mehmetfurkandogan/CNC-modernization/Literature search notes/MFD Literature Search.md

## Controller Options

🤔 Online or offline controller

- [Klipper3D](https://www.klipper3d.org/)

- [LinuxCNC](http://linuxcnc.org/)
  
  [Emco Compact 5 to LinuxCNC conversion. Introduction video.](https://www.youtube.com/watch?v=JxlS0DMkwLA)

- [OctoPrint](https://octoprint.org/)

- [DDCS v3.1](http://www.ddcnc.com/?m=home&c=View&a=index&aid=119&lang=en)
  
  [Build Your Own CNC Controller, Part 1 | DDCS V3.1 | 6040 Router](https://www.youtube.com/watch?v=X-DY6iL6NcI)
  
  - Variable Frequency Drive (VFD)

- [Mach3 CNC](https://www.machsupport.com/software/mach3/)
  
  [4 Eksen CNC Kontrol Kartı Mach3 USB Uyumlu](https://www.robolinkmarket.com/4-eksen-cnc-kontrol-karti-mach3-usb-uyumlu)
  
  [5 Eksen CNC Kontrol Kartı (MACH3 Uyumlu)](https://www.robolinkmarket.com/5-eksen-cnc-kontrol-karti-mach3-uyumlu)

- [Marlin](https://marlinfw.org/)

- [OpenBuilds](https://openbuilds.com/)

---

There is a 3 axis TB6560 driver board on the lathe right now.

[Board DataSheet](https://github.com/mehmetfurkandogan/CNC-modernization/blob/main/Documents/Stepper%20Motor%20Driver/3%20Axis%20TB6560%203.5A%20Stepper%20Motor%20Driver%20Board%20Man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)

[Toshiba TB6560AHQ chip DataSheet](https://www.mouser.com.tr/datasheet/2/408/Toshiba_TB6560AHQ_datasheet_en_20141001__3_-2325890.pdf)

[Tb6560 stepping motor driver board](https://www.direnc.net/tb6560-3-5a-step-motor-surucu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) [**DataSheet**](https://pdf.direnc.net/upload/tb6560-3-5a-step-motor-surucu-stepping-motor-driver-datasheet.pdf) 

 [winder](https://github.com/winder)/[**Universal-G-Code-Sender**](https://github.com/winder/Universal-G-Code-Sender) [UGS](https://winder.github.io/ugs_website/) to create g-codes

 [gnea](https://github.com/gnea)/**[grbl](https://github.com/gnea/grbl)**  can be used with arduino

 [picatostas](https://github.com/picatostas)/**[cnc_interface](https://github.com/picatostas/cnc_interface)** can be used for ROS integration

 [grblHAL](https://github.com/grblHAL)/**[RP2040](https://github.com/grblHAL/RP2040)** GRBL for RP2040
