mehmetfurkandogan/CNC-modernization/CNC Lathe Inspection Report/WhatsApp Image 2023-04-20 at 13.09.05.jpg

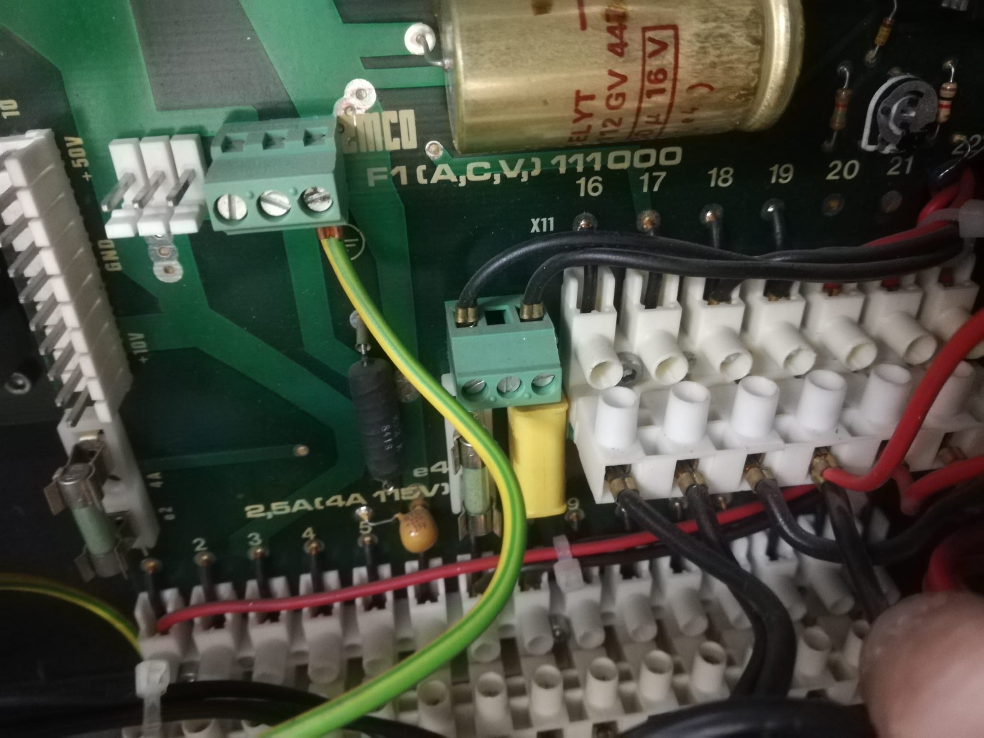
CNC Lathe Inspection Report/WhatsApp Image 2023-04-20 at 13.09.05.jpg
