mehmetfurkandogan/CNC-modernization/Documents/2023-05-25_001082.jpg

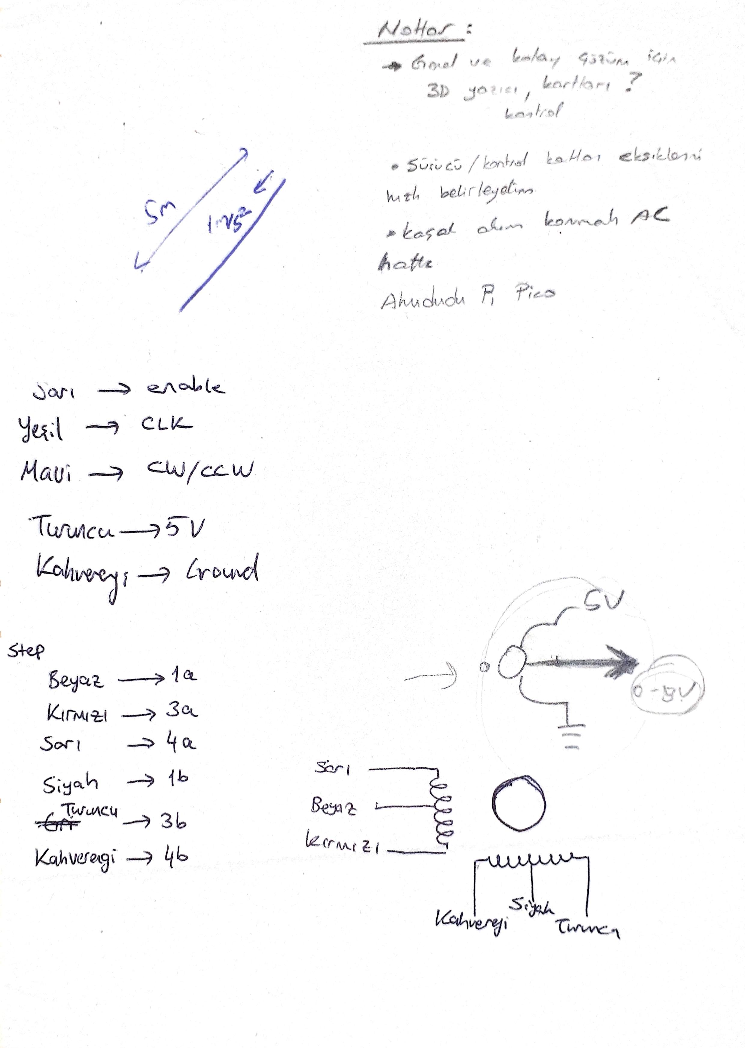
Documents/2023-05-25_001082.jpg
