mehmetfurkandogan/CNC-modernization/Documents/emco-compact-5-cnc-1.snapshot.6/Renderings/Emco Compact 5 CNC render.png

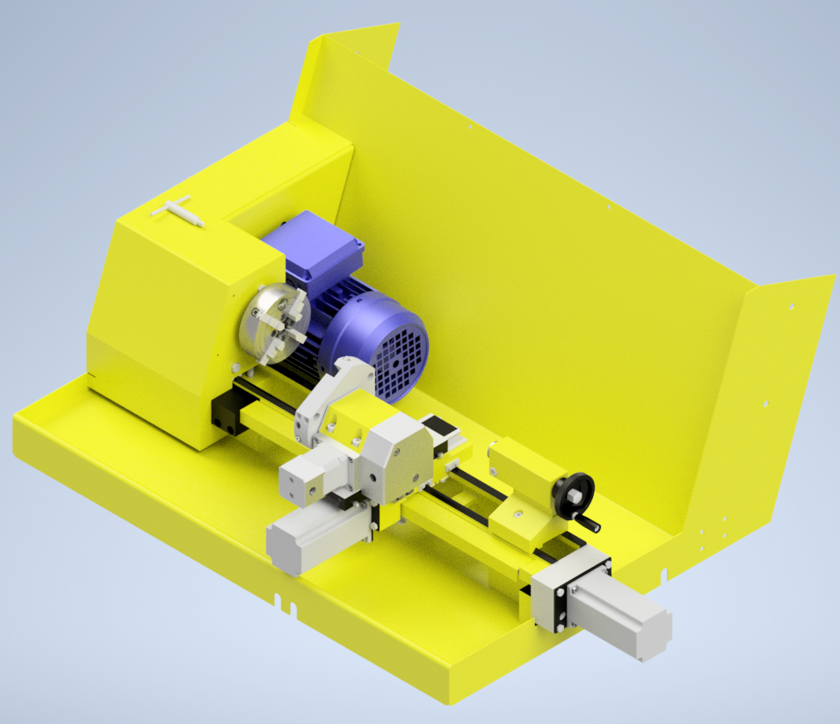
Documents/emco-compact-5-cnc-1.snapshot.6/Renderings/Emco Compact 5 CNC render.png
