mehmetfurkandogan/CNC-modernization/Documents/Encoder_schematic.webp

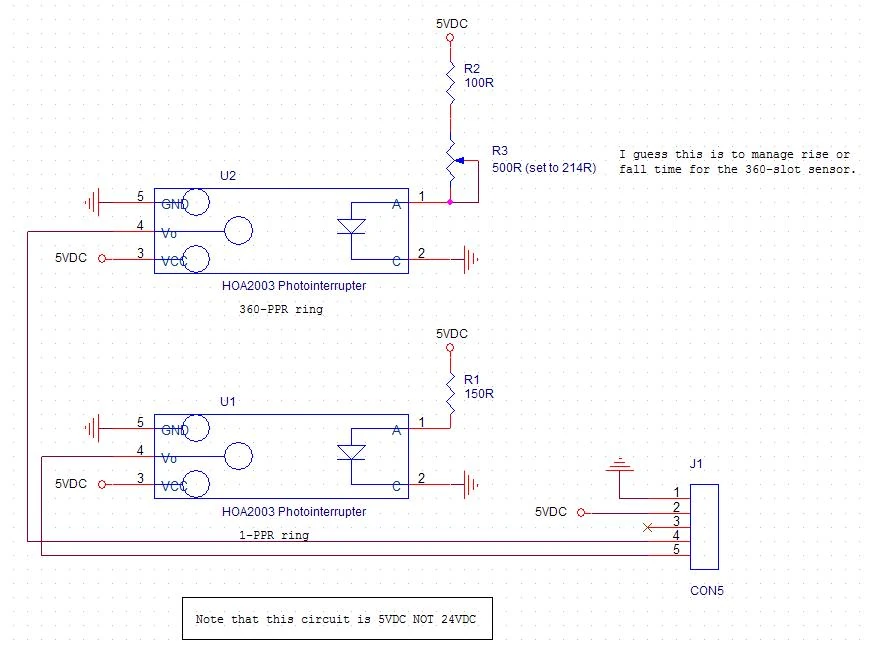
Documents/Encoder_schematic.webp
