mehmetfurkandogan/CNC-modernization/Documents/Spindle_specs.jpeg

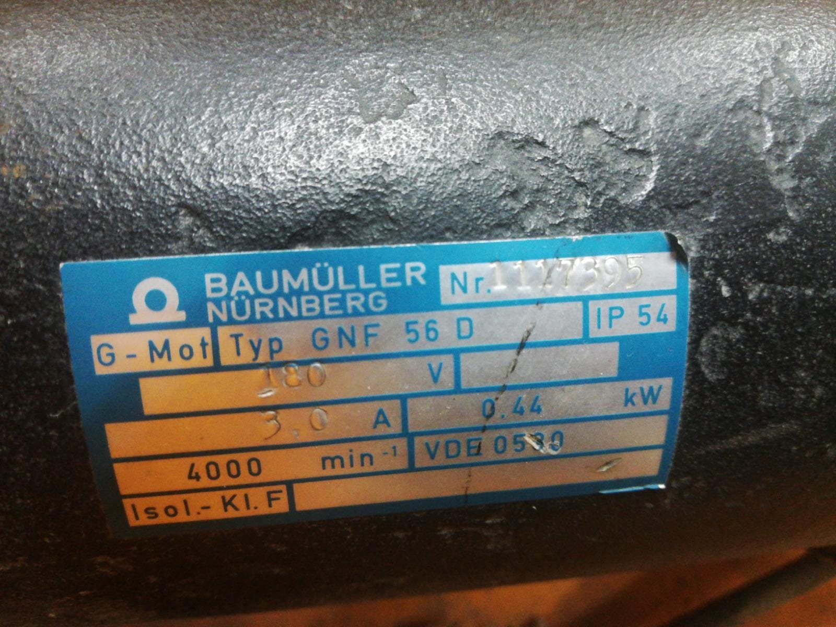
Documents/Spindle_specs.jpeg
