mehmetfurkandogan/CNC-modernization/Documents/Stepper Motor Driver/TB6560/Schematic.jpg

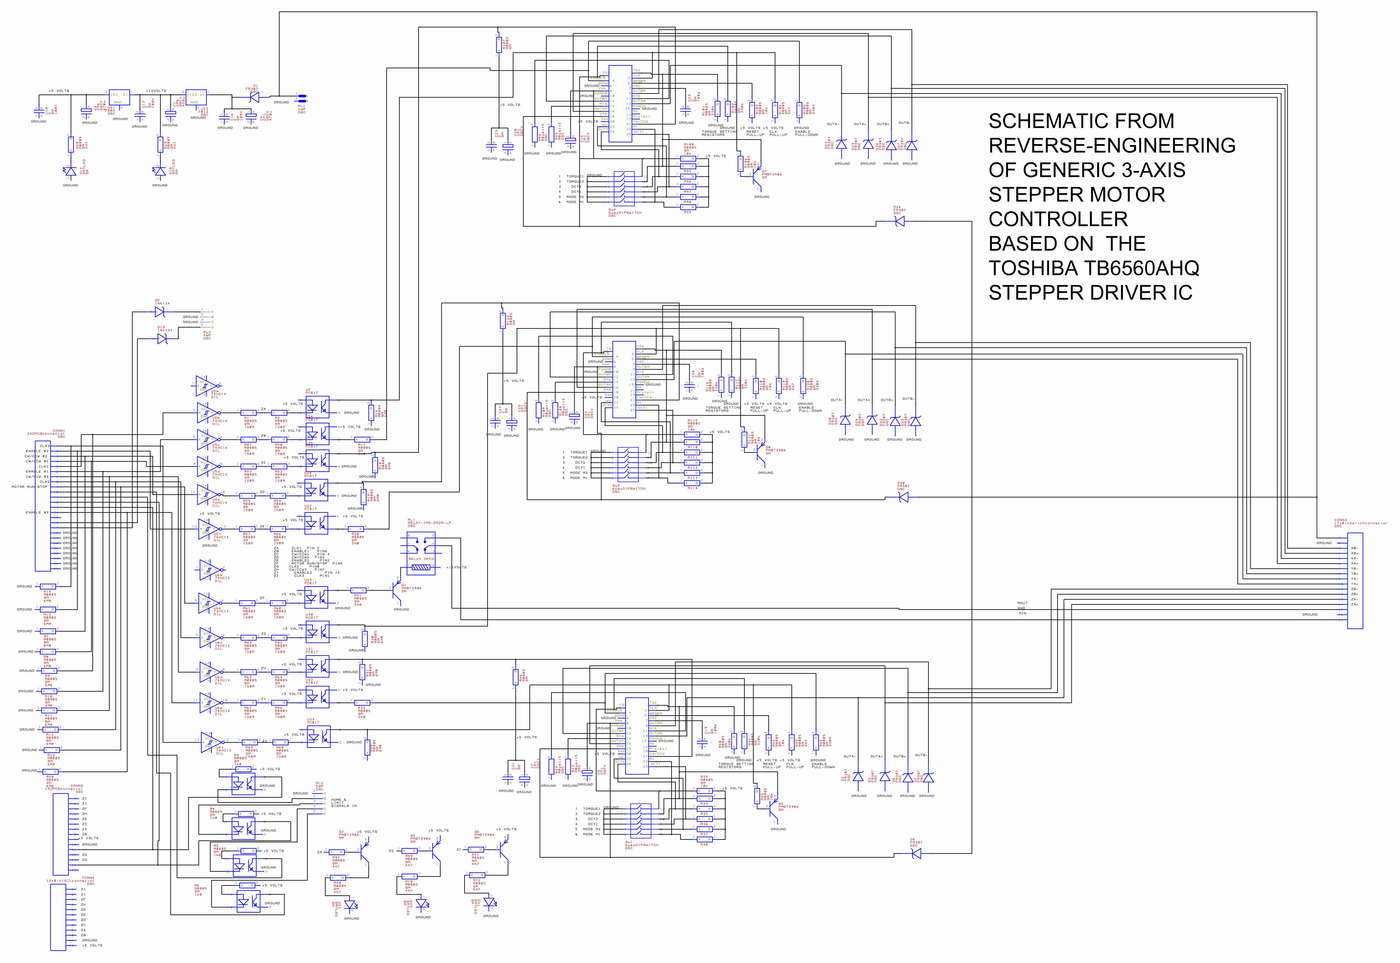
Documents/Stepper Motor Driver/TB6560/Schematic.jpg
