mehmetfurkandogan/CNC-modernization/Documents/Stepper Motor Driver/TB6560/TB6560-CNC.jpg

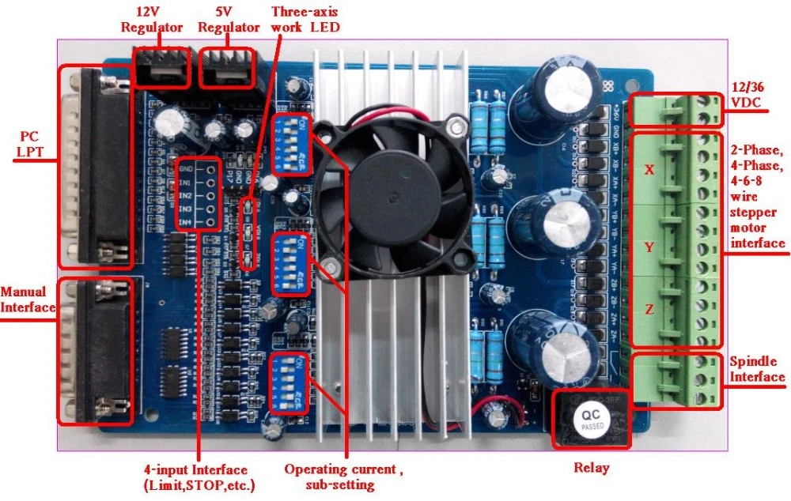
Documents/Stepper Motor Driver/TB6560/TB6560-CNC.jpg
