mehmetfurkandogan/CNC-modernization/Documents/tb6600-2.snapshot.1/TB6600 1.bmp

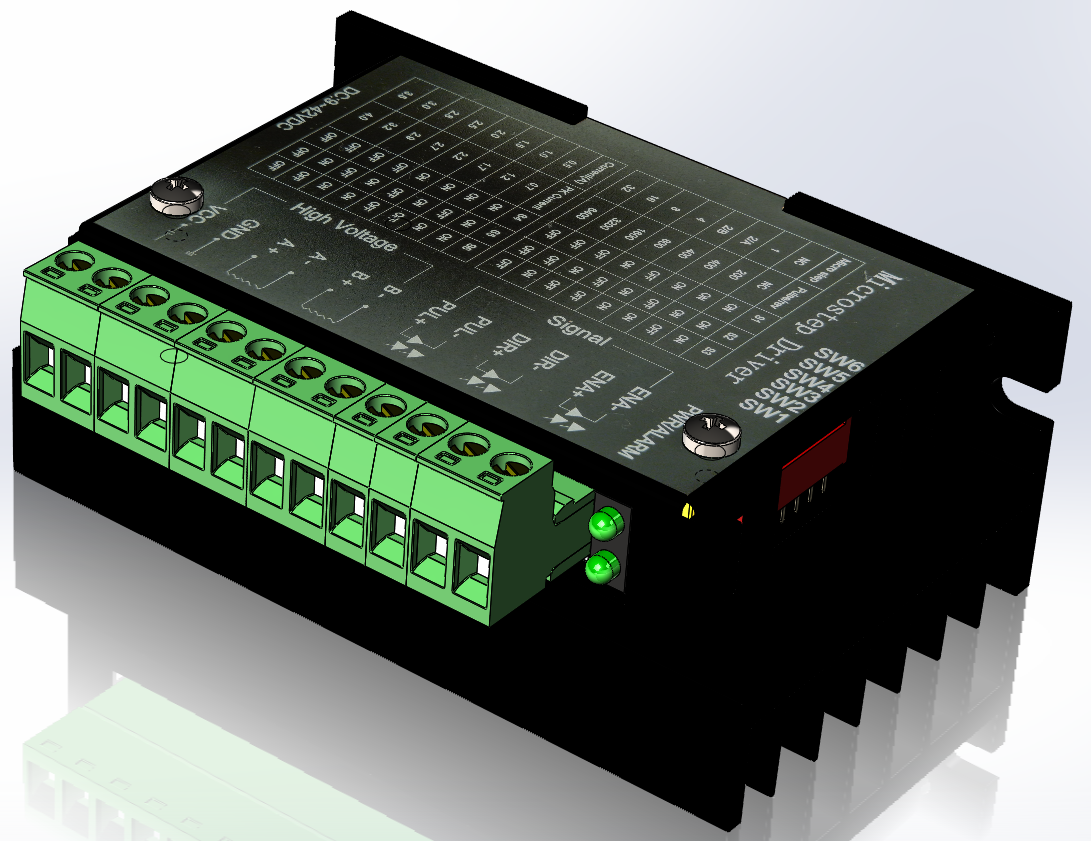
Documents/tb6600-2.snapshot.1/TB6600 1.bmp
