mehmetfurkandogan/CNC-modernization/Documents/tb6600-2.snapshot.1/TB6600 Cover.jpg

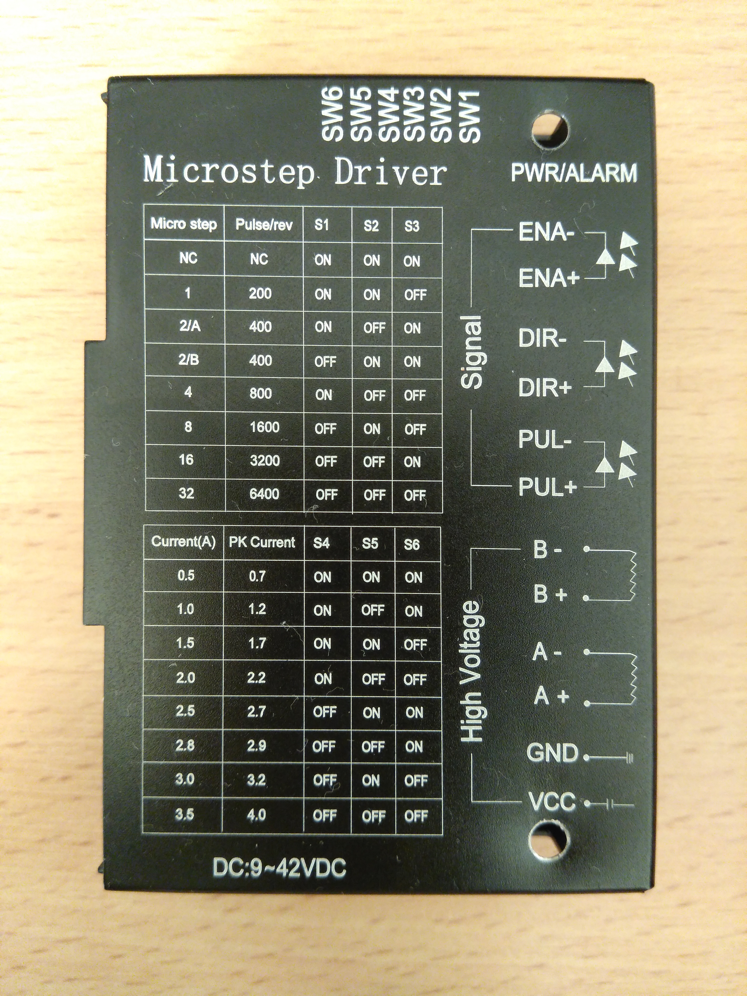
Documents/tb6600-2.snapshot.1/TB6600 Cover.jpg
