mehmetfurkandogan/CNC-modernization/Meetings/Meeting 2/EMCO.jpeg

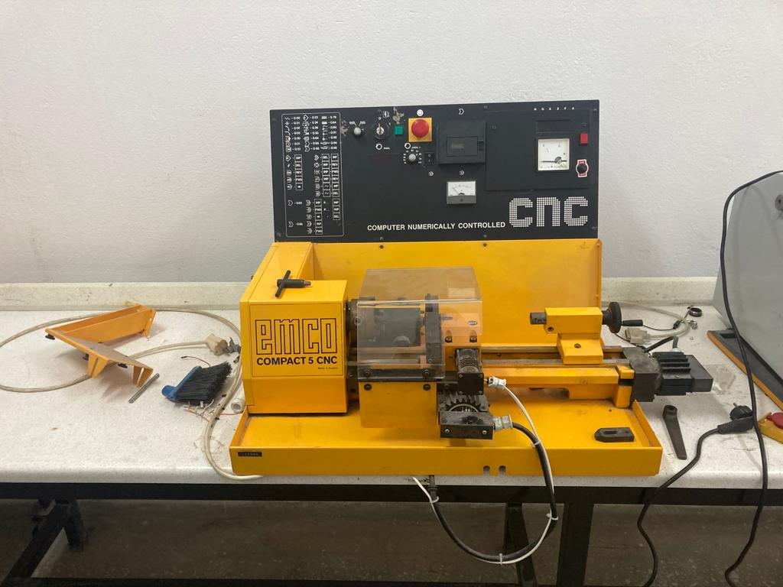
Meetings/Meeting 2/EMCO.jpeg
