mehmetfurkandogan/CNC-modernization/Meetings/Meeting 3/IMG-20230413-WA0009.jpg

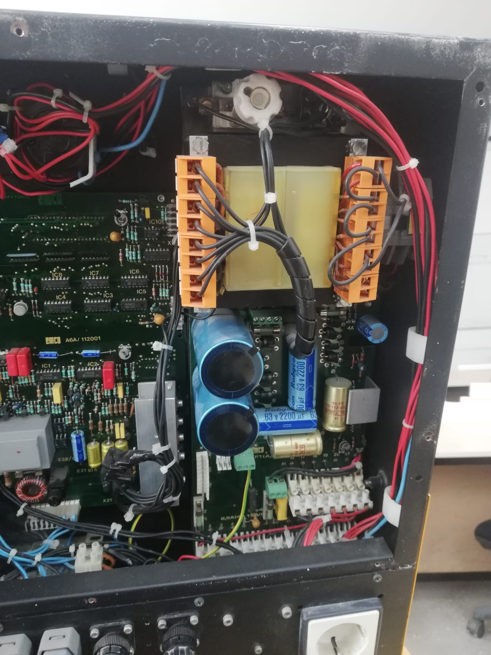
Meetings/Meeting 3/IMG-20230413-WA0009.jpg
