mehmetfurkandogan/CNC-modernization/Meetings/Meeting 3/IMG-20230413-WA0010.jpg

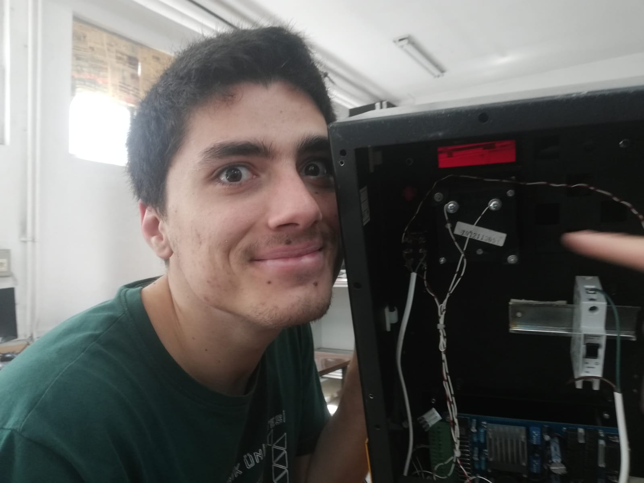
Meetings/Meeting 3/IMG-20230413-WA0010.jpg
