mehmetfurkandogan/CNC-modernization/Meetings/Meeting 3/IMG-20230413-WA0012.jpg

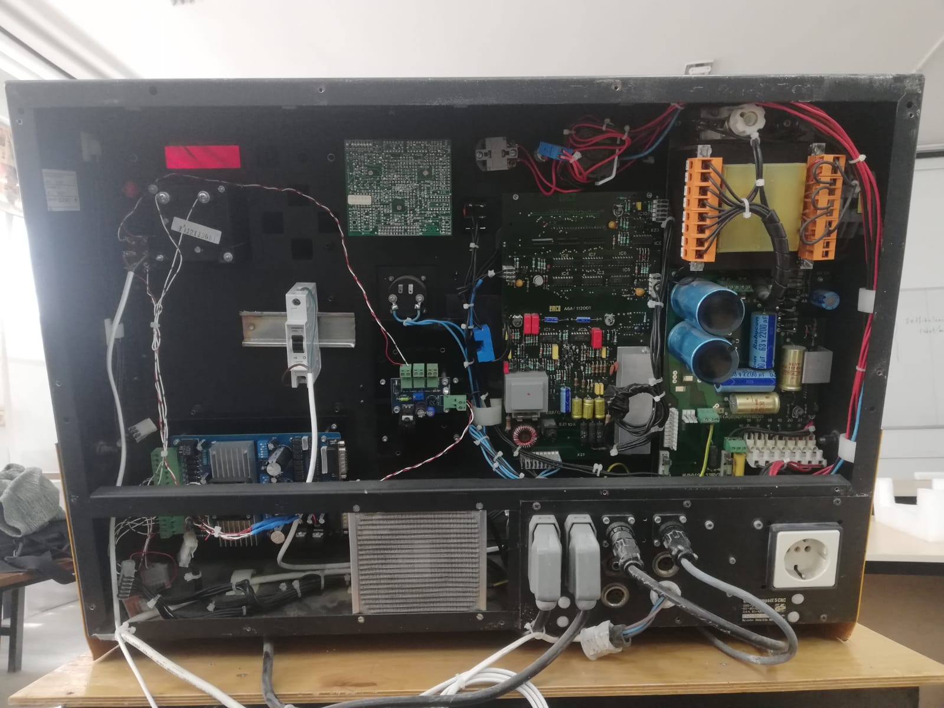
Meetings/Meeting 3/IMG-20230413-WA0012.jpg
