mehmetfurkandogan/CNC-modernization/Meetings/Meeting 3/IMG-20230413-WA0015.jpg

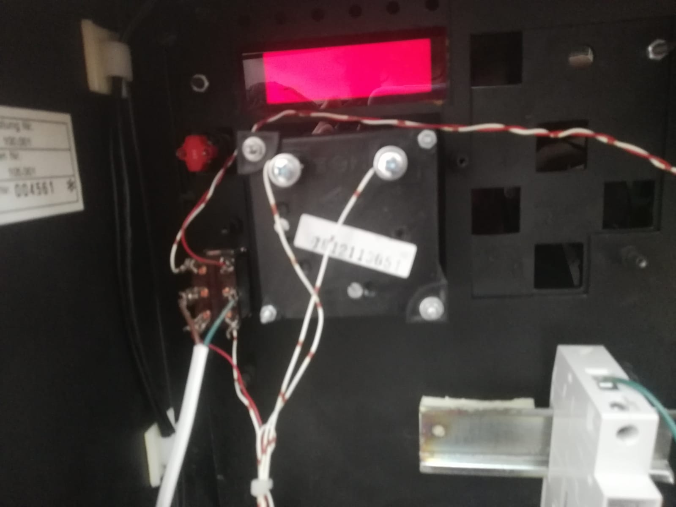
Meetings/Meeting 3/IMG-20230413-WA0015.jpg
