mehmetfurkandogan/CNC-modernization/Meetings/Meeting 3/IMG-20230413-WA0016.jpg

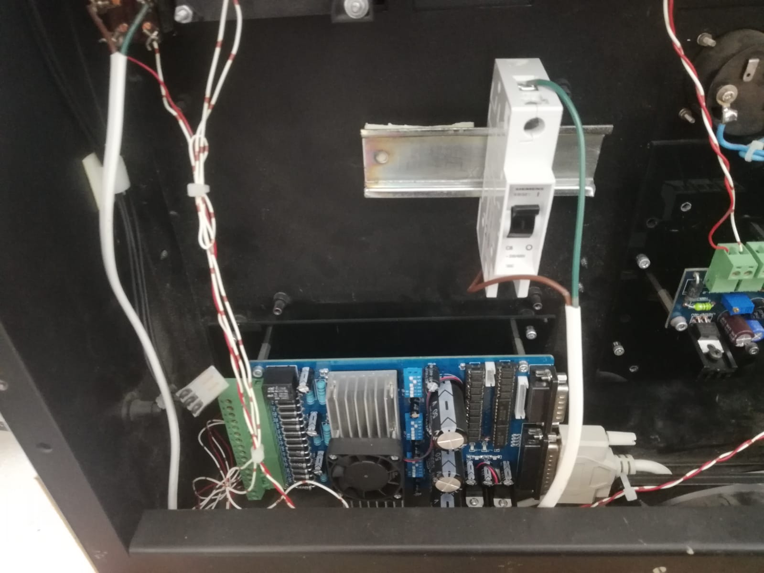
Meetings/Meeting 3/IMG-20230413-WA0016.jpg
