mehmetfurkandogan/CNC-modernization/Meetings/Meeting 18.05.23/ss.png

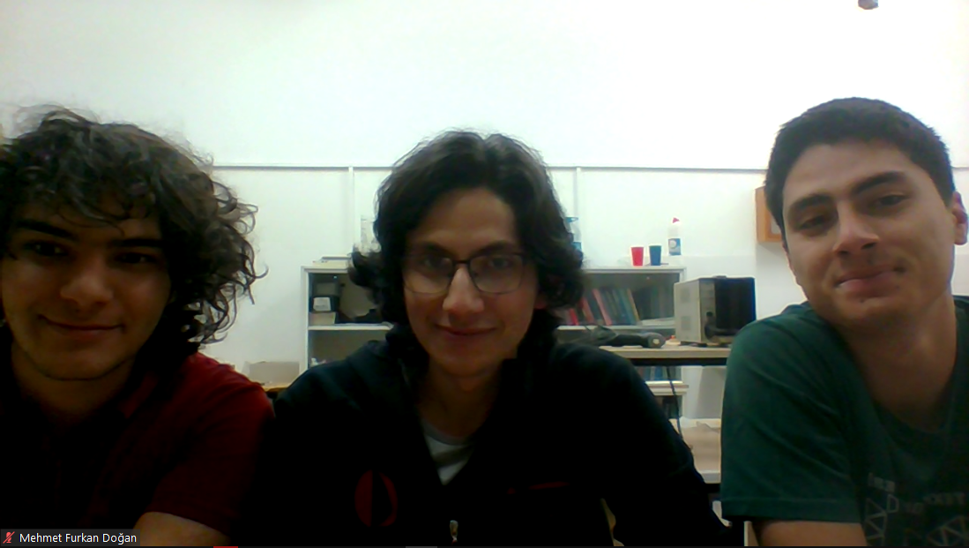
Meetings/Meeting 18.05.23/ss.png
