mehmetfurkandogan/CNC-modernization/Pictures/CNC_GeneralView.jpeg

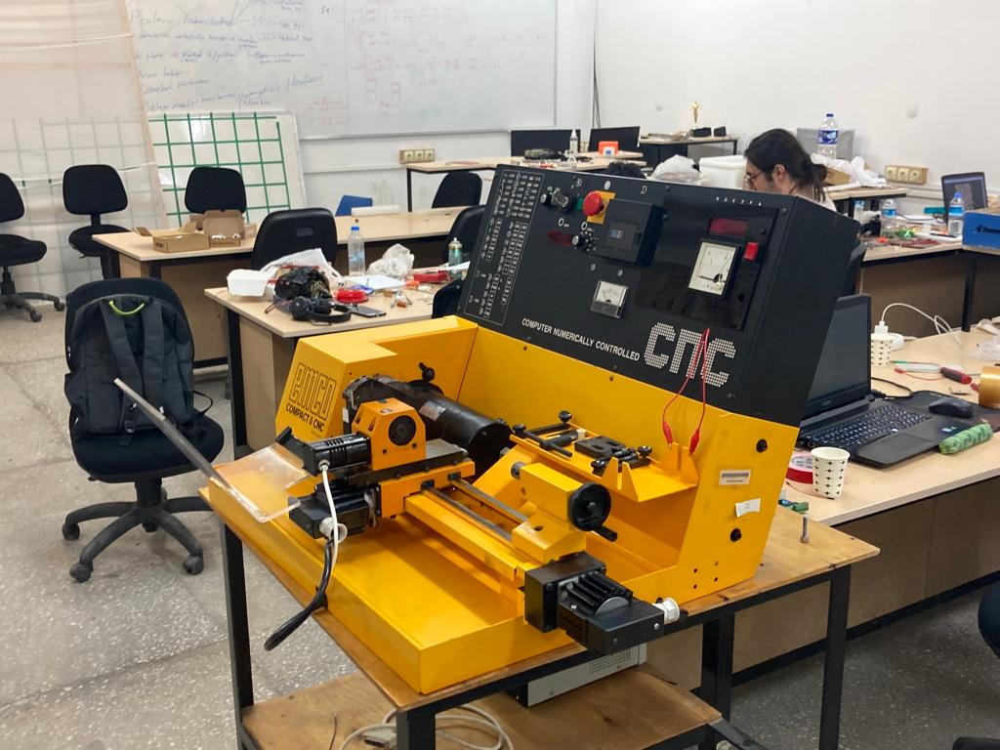
Pictures/CNC_GeneralView.jpeg
