mehmetfurkandogan/CNC-modernization/Pictures/FrontView_Console2.jpeg

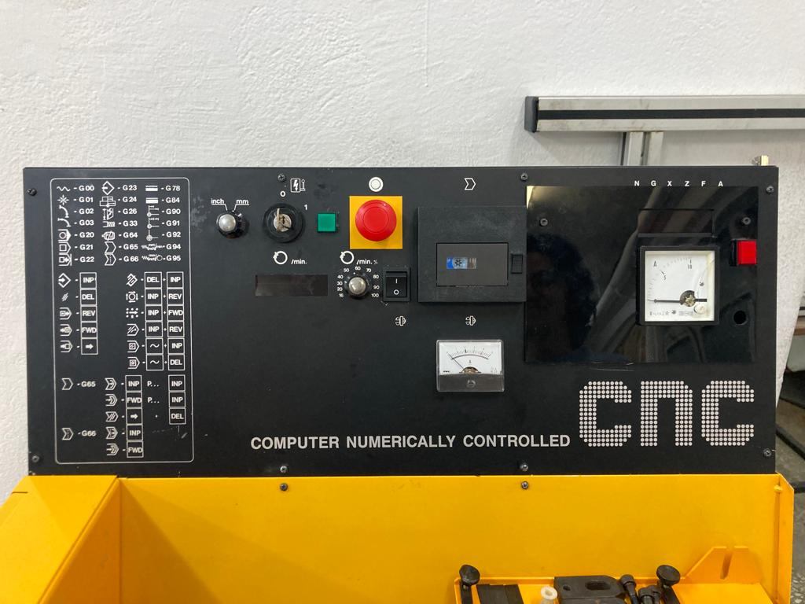
Pictures/FrontView_Console2.jpeg
