mehmetfurkandogan/CNC-modernization/Pictures/FrontView_Console3.jpeg

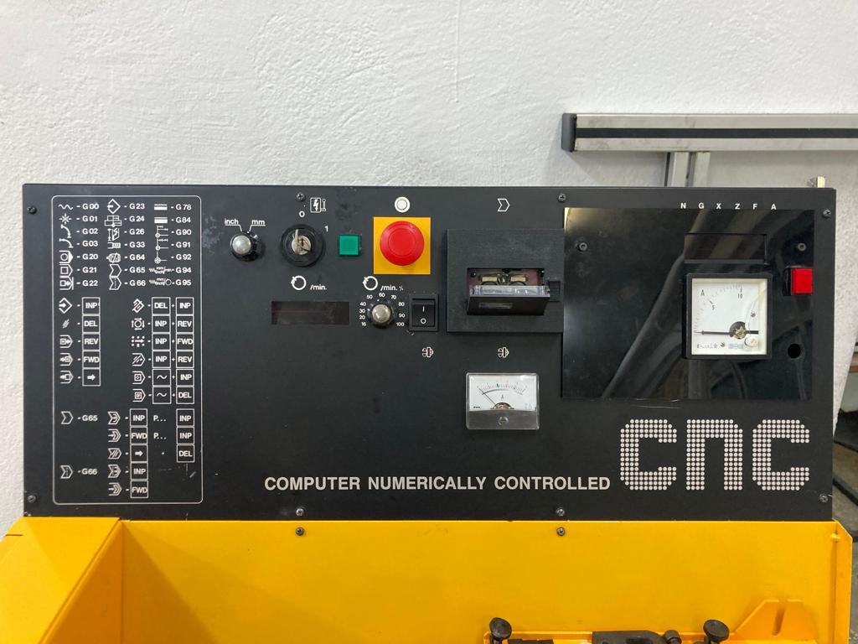
Pictures/FrontView_Console3.jpeg
