mehmetfurkandogan/CNC-modernization/Pictures/FrontView_Console.jpeg

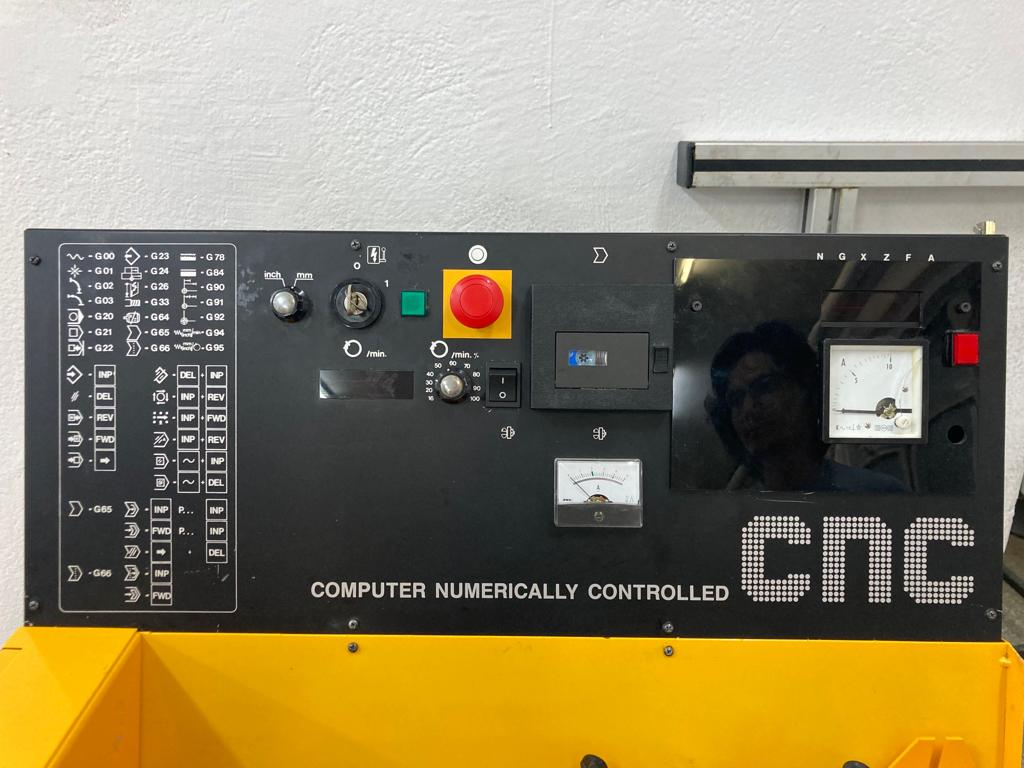
Pictures/FrontView_Console.jpeg
