mehmetfurkandogan/CNC-modernization/Pictures/PowerSupply_Info.jpeg

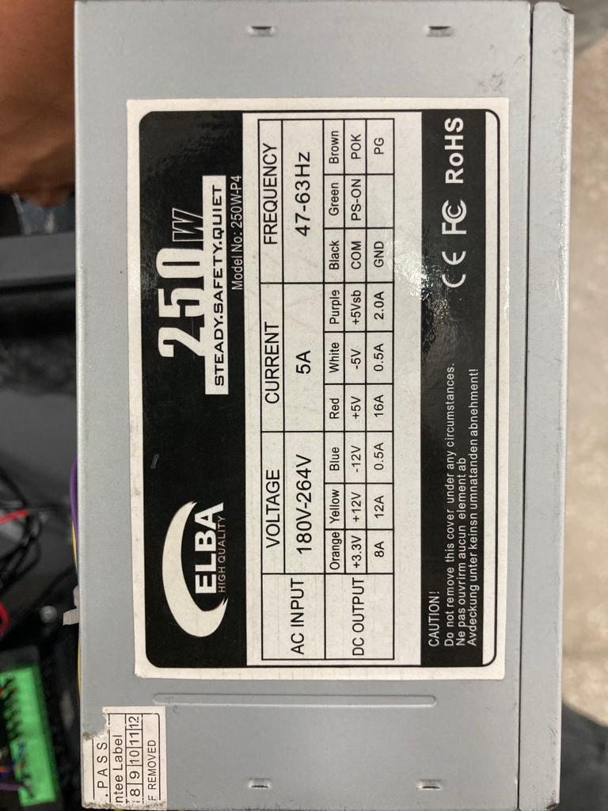
Pictures/PowerSupply_Info.jpeg
