mehmetfurkandogan/CNC-modernization/Pictures/RearView_Closed2.jpeg

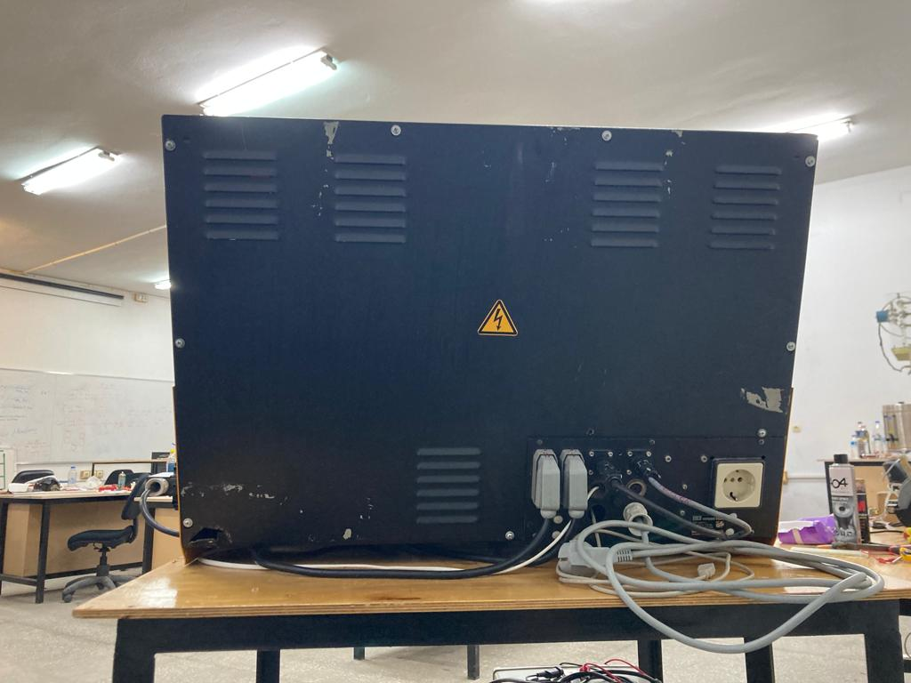
Pictures/RearView_Closed2.jpeg
