mehmetfurkandogan/CNC-modernization/Pictures/RearView_Closed3.jpeg

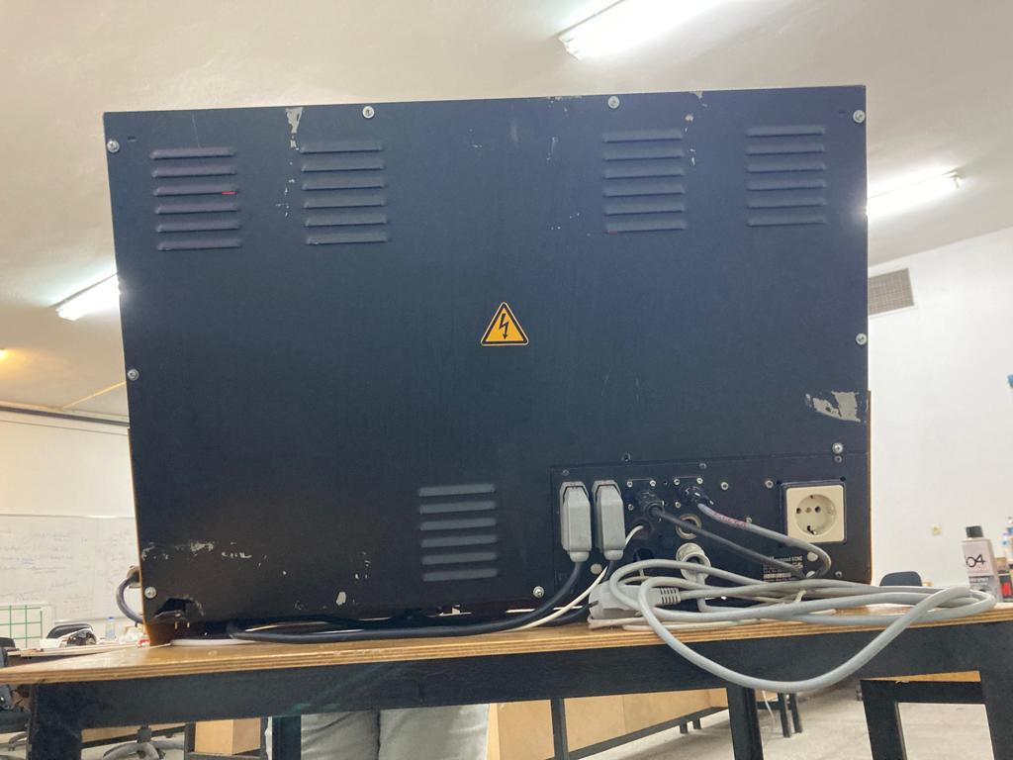
Pictures/RearView_Closed3.jpeg
