mehmetfurkandogan/CNC-modernization/Pictures/RearView_Closed.jpeg

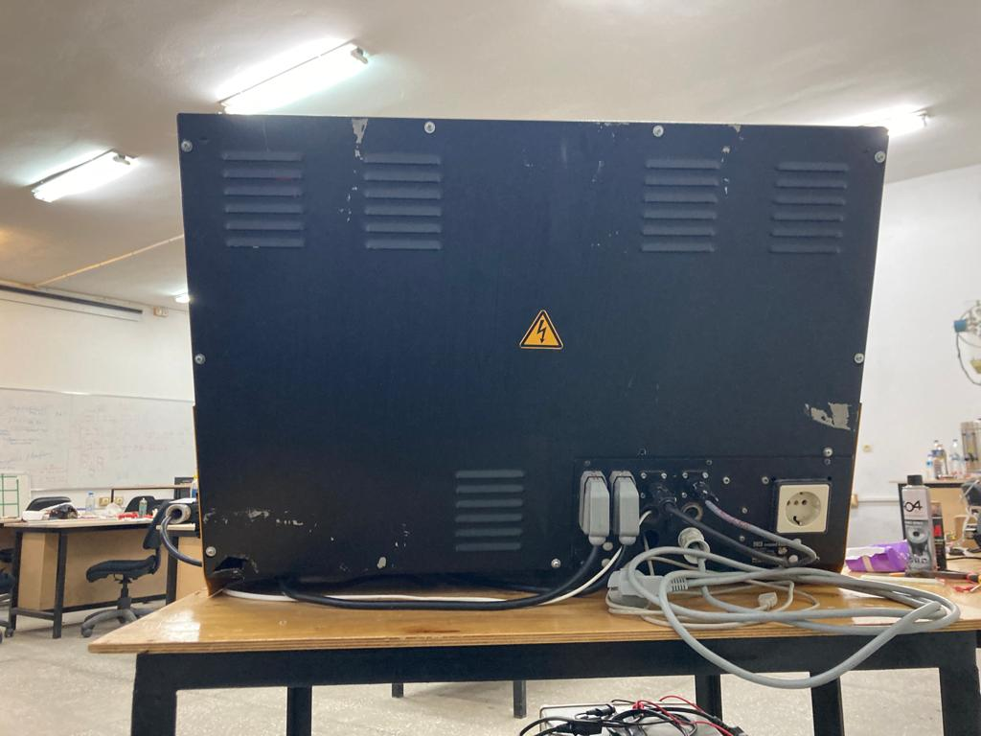
Pictures/RearView_Closed.jpeg
