mehmetfurkandogan/CNC-modernization/Pictures/RearView_Closed_Connectors.jpeg

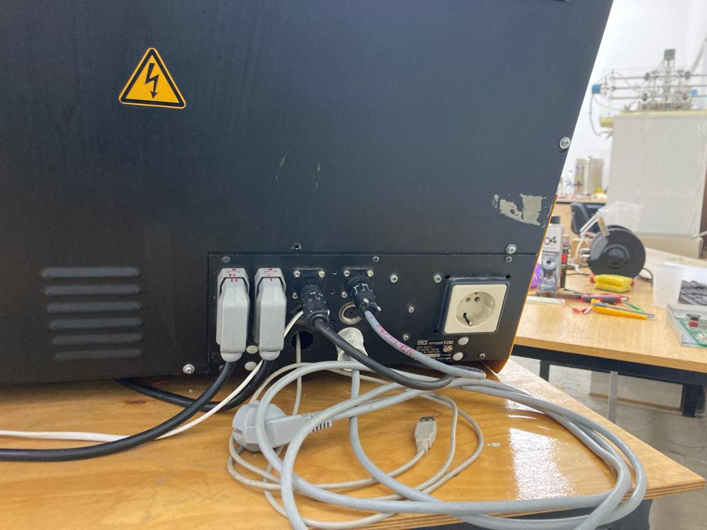
Pictures/RearView_Closed_Connectors.jpeg
