mehmetfurkandogan/CNC-modernization/Pictures/RearView_Open3.jpeg

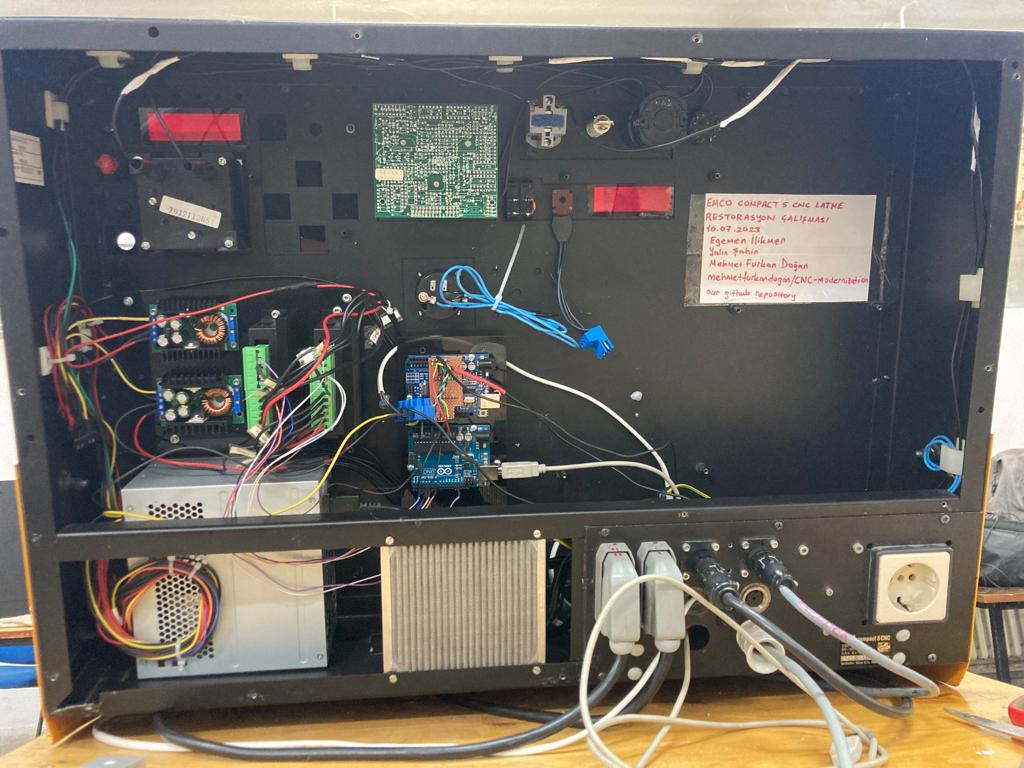
Pictures/RearView_Open3.jpeg
