mehmetfurkandogan/CNC-modernization/Pictures/RearView_Open.jpeg

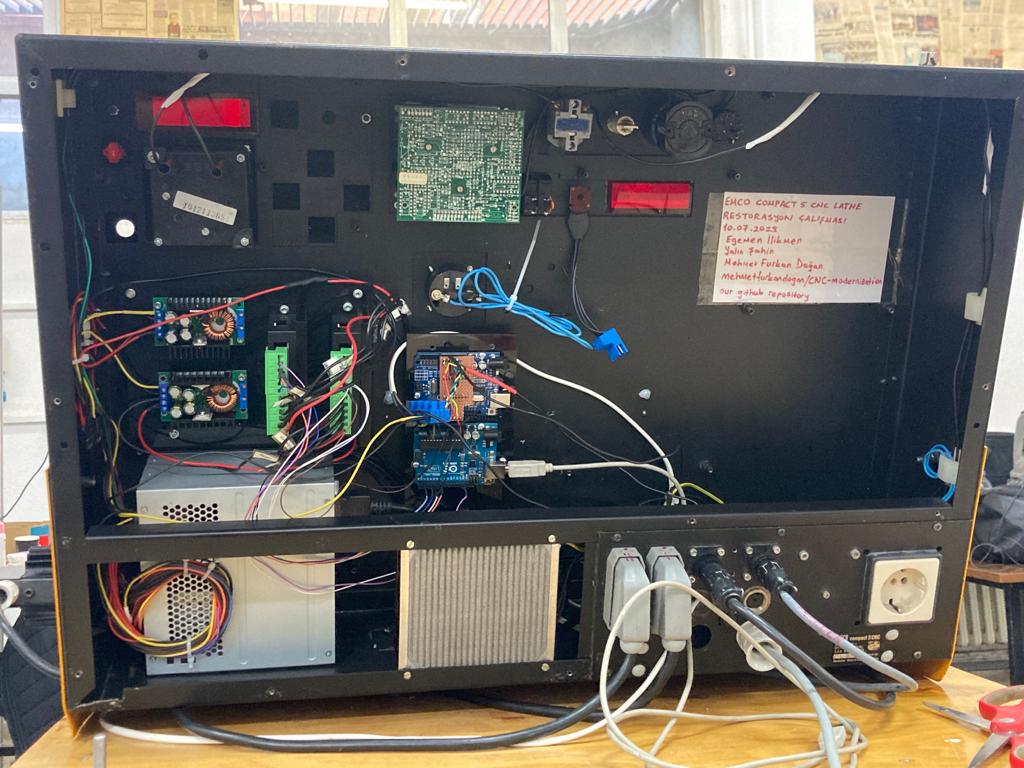
Pictures/RearView_Open.jpeg
