mehmetfurkandogan/CNC-modernization/Documents/tb6600-2.snapshot.1/LED 3mm Double Stand.STEP

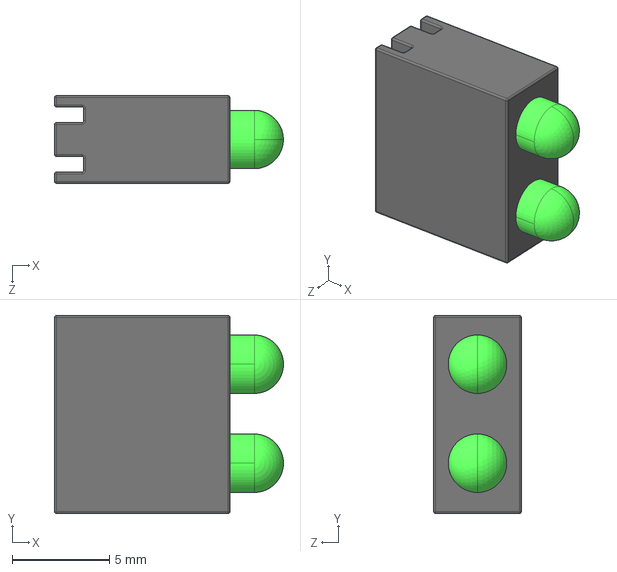
[picture p39: CAD file, 2023-05-17]
Documents/tb6600-2.snapshot.1/LED 3mm Double Stand.STEP
11.7 x 10.2 x 4.50 mm
