mehmetfurkandogan/CNC-modernization/Documents/tb6600-2.snapshot.1/TB6600 Cover.STEP

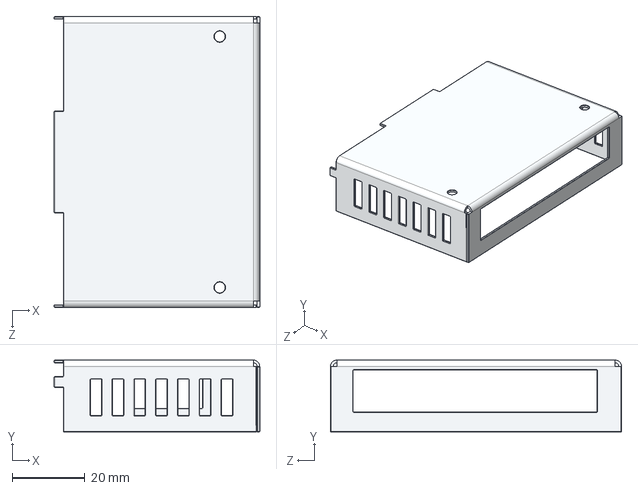
[picture p40: CAD file, 2023-05-17]
Documents/tb6600-2.snapshot.1/TB6600 Cover.STEP
56.5 x 19.8 x 80.0 mm
