mehmetfurkandogan/CNC-modernization/Documents/tb6600-2.snapshot.1/a6fr-6101.STEP

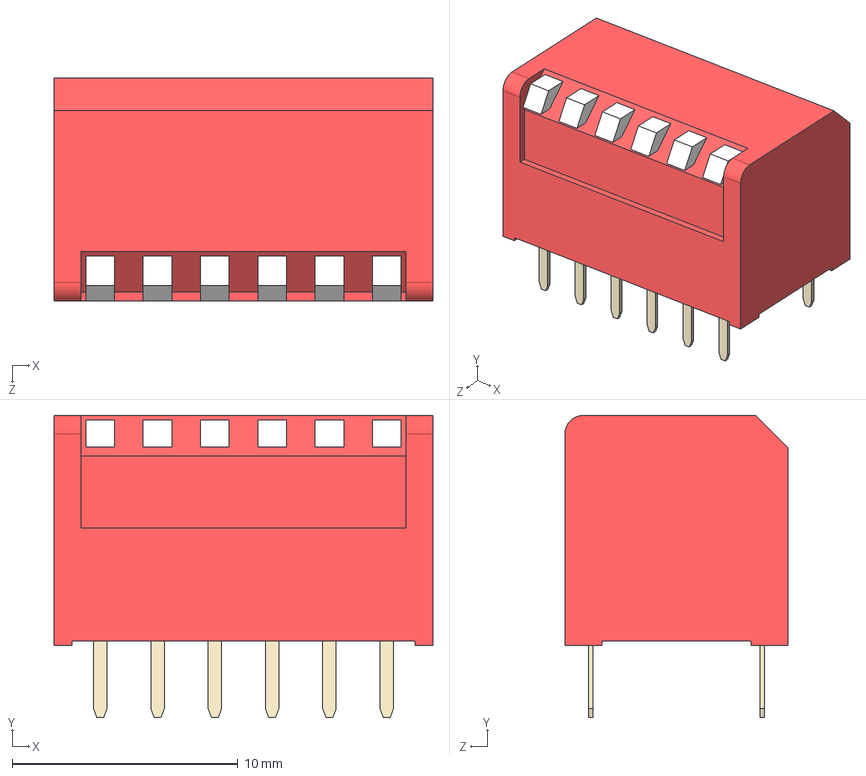
[picture p41: CAD file, 2023-05-17]
Documents/tb6600-2.snapshot.1/a6fr-6101.STEP
16.8 x 13.4 x 9.90 mm
