mehmetfurkandogan/CNC-modernization/Documents/tb6600-2.snapshot.1/Header 200mil.STEP

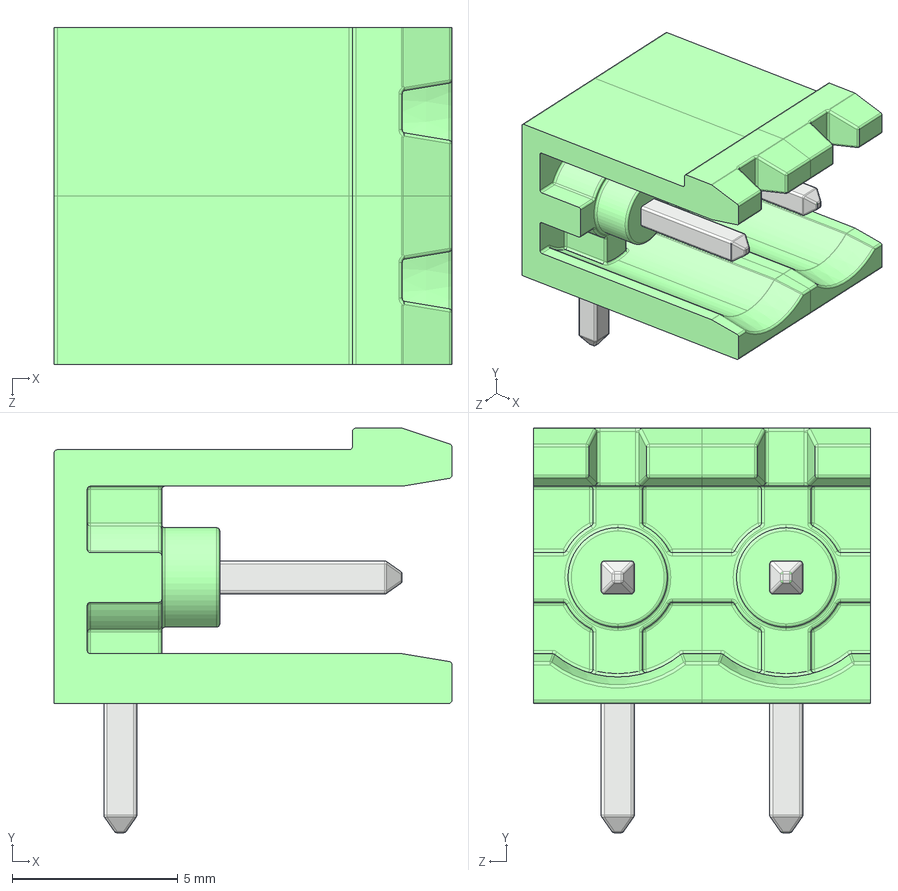
[picture p42: CAD file, 2023-05-17]
Documents/tb6600-2.snapshot.1/Header 200mil.STEP
12.0 x 12.2 x 10.2 mm
