mehmetfurkandogan/CNC-modernization/Documents/tb6600-2.snapshot.1/Plug 200mil.STEP

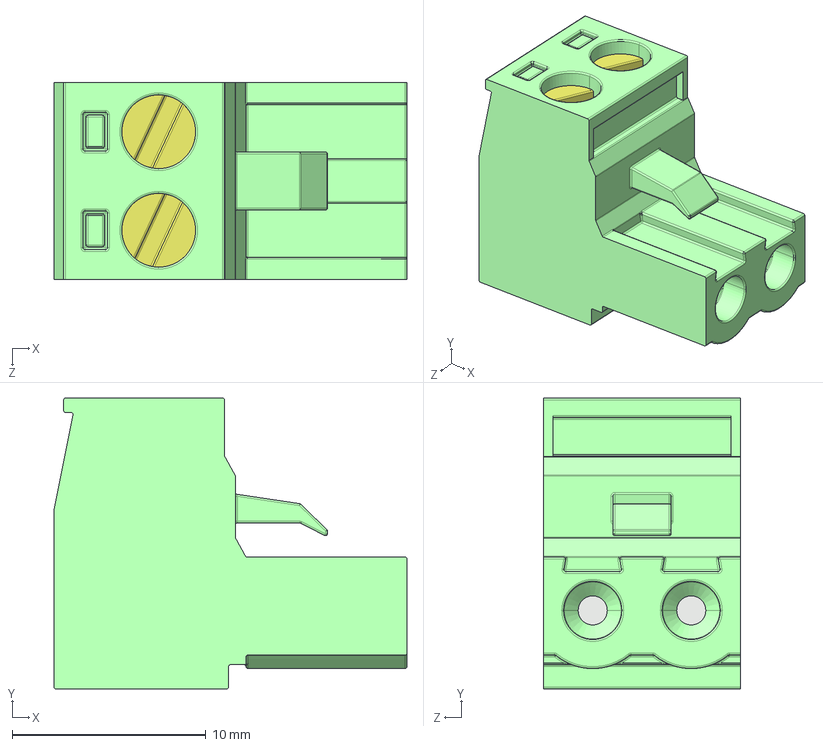
[picture p43: CAD file, 2023-05-17]
Documents/tb6600-2.snapshot.1/Plug 200mil.STEP
18.2 x 15.0 x 10.2 mm
