mehmetfurkandogan/CNC-modernization/Documents/tb6600-2.snapshot.1/Distance.STEP

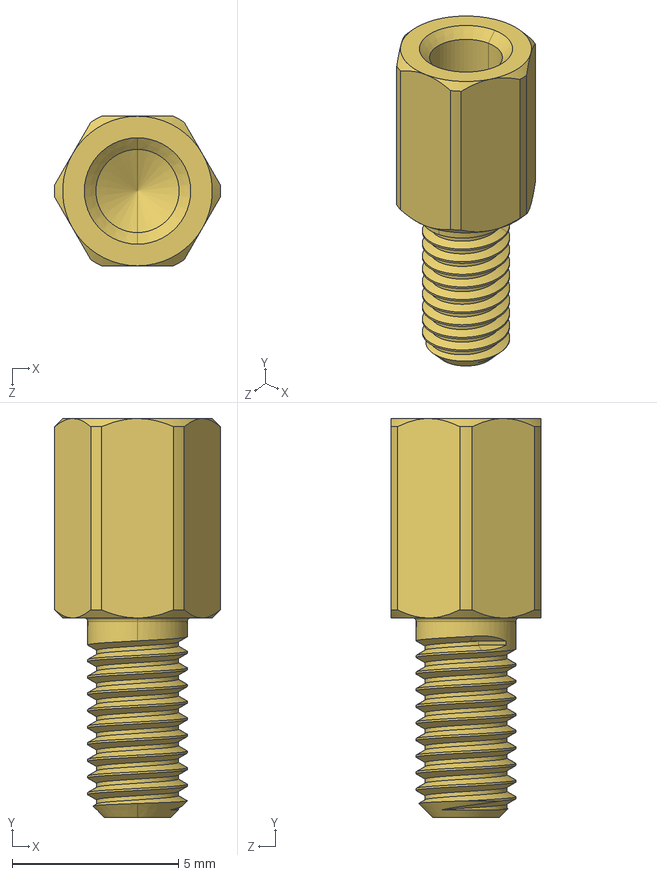
[picture p44: CAD file, 2023-05-17]
Documents/tb6600-2.snapshot.1/Distance.STEP
4.99 x 12.0 x 4.50 mm
