mehmetfurkandogan/CNC-modernization/Documents/tb6600-2.snapshot.1/TB6600 Sink.STEP

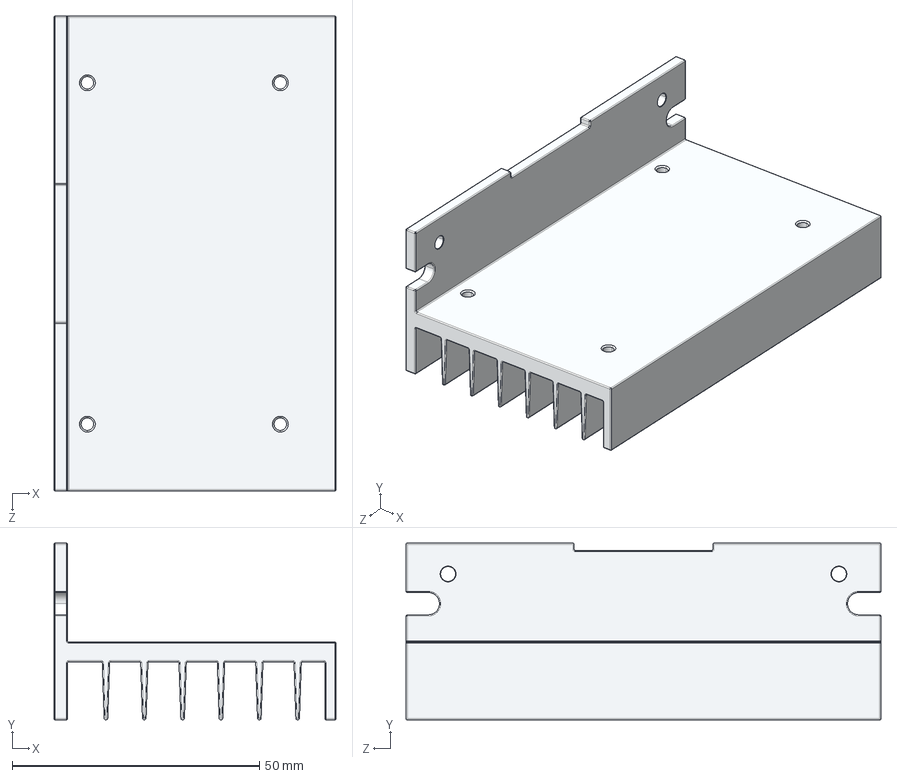
[picture p45: CAD file, 2023-05-17]
Documents/tb6600-2.snapshot.1/TB6600 Sink.STEP
57.0 x 35.8 x 96.0 mm
