mehmetfurkandogan/CNC-modernization/(list of files, cad)

Other CAD files:
Documents/tb6600-2.snapshot.1/Distance.IGS
Documents/tb6600-2.snapshot.1/Distance.SLDPRT
Documents/tb6600-2.snapshot.1/Header 200mil.IGS
Documents/tb6600-2.snapshot.1/LED 3mm Double Stand.IGS
Documents/tb6600-2.snapshot.1/LED 3mm Double Stand.SLDPRT
Documents/tb6600-2.snapshot.1/Plug 200mil.IGS
Documents/tb6600-2.snapshot.1/TB6600 Cover.IGS
Documents/tb6600-2.snapshot.1/TB6600 Cover.SLDPRT
Documents/tb6600-2.snapshot.1/TB6600 Sink.IGS
Documents/tb6600-2.snapshot.1/TB6600 Sink.SLDPRT
Documents/tb6600-2.snapshot.1/a6fr-6101.IGS
Documents/tb6600-2.snapshot.1/a6fr-6101.SLDPRT
