mehmetfurkandogan/CNC-modernization/Documents/x-axis-step-specs.jpg

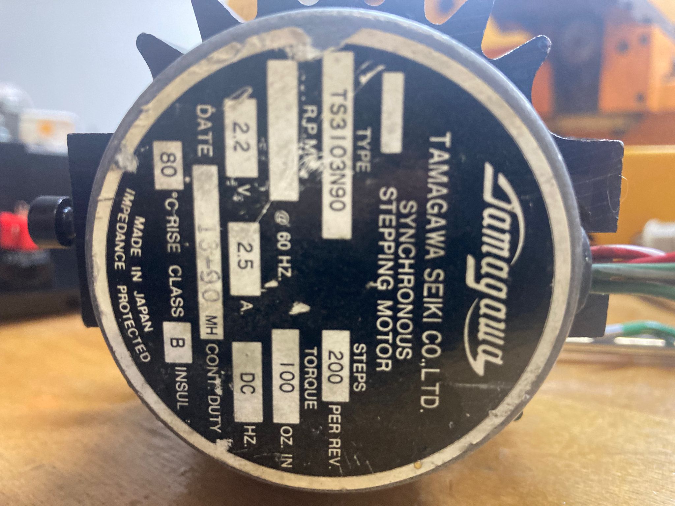
Documents/x-axis-step-specs.jpg
