mehmetfurkandogan/CNC-modernization/Documents/z-and-x-steps.jpeg

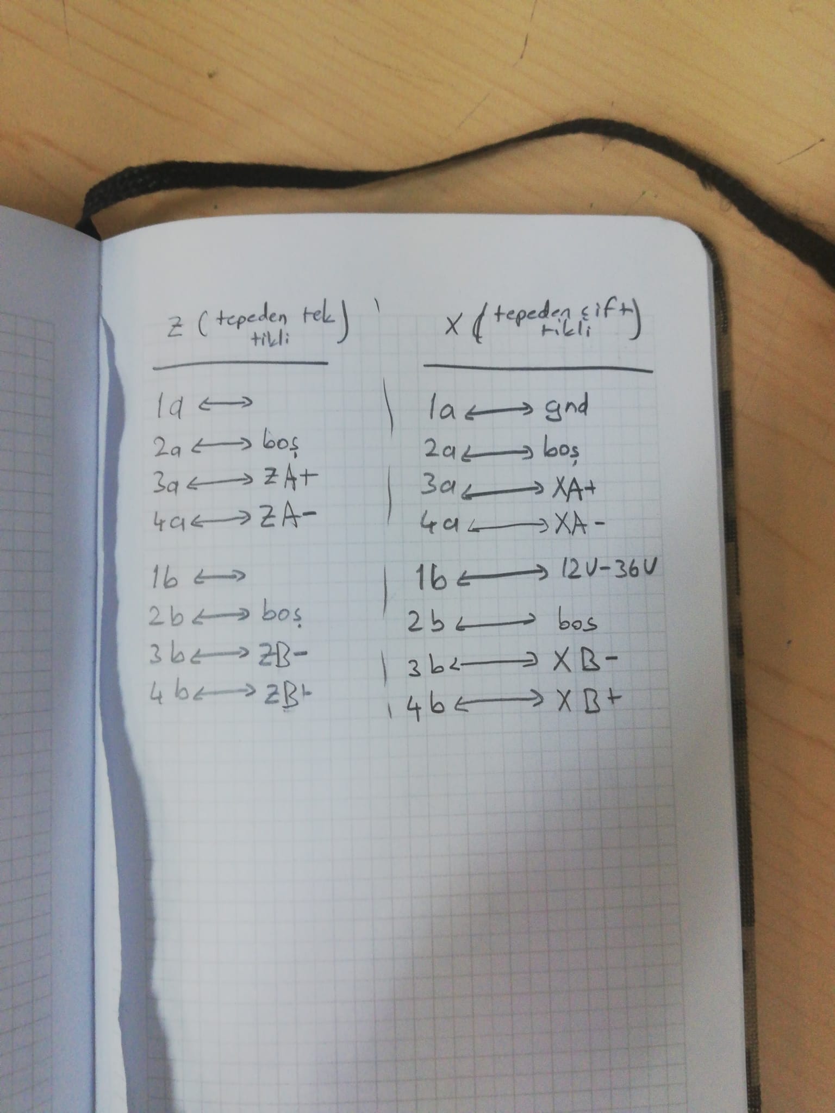
Documents/z-and-x-steps.jpeg
