mehmetfurkandogan/CNC-modernization/codes/tool_changer_integrated_with_gcode/tool_changer_integrated_with_gcode.ino

#define PWM1 9
#define AIN1 10
#define AIN2 11

int motor_speed;
bool motor_direction;
bool tool_change = false;
// int incomingNumber;
unsigned long startTime;
bool cw = false;
bool ccw = false;
int Tool = 1;

int high_start_time = 0;
bool flag = false;
int desired_tool = 1;
int duration = 0;

void IRS() {
  high_start_time = millis();
  flag = true;
}

void change_tool(int inputNumber) {
  int incomingNumber = ((inputNumber - Tool) % 6 + 6) % 6;
  // Serial.println(incomingNumber);
  if (incomingNumber && tool_change == false) {
    tool_change = true;
    cw = true;
    ccw = false;
    motor_direction = true;
    startTime = millis();
  }
  if (millis() - startTime >= 2000 && tool_change && cw) {
    cw = false;
    ccw = true;
    motor_direction = false;
    startTime = millis();
  }
  if (millis() - startTime >= 500 && tool_change && ccw) {
    cw = true;
    ccw = false;
    motor_direction = true;
    incomingNumber -= 1;
    Tool = (Tool + 1) % 6;
    //    Serial.print("Tool Number:");
    //    Serial.println(Tool);
    if (incomingNumber == 0) {
      tool_change = false;
      motor_direction = false;
      cw = false;
      ccw = false;
    } else {
      startTime = millis();
    }
  }

  if (motor_direction) {
    digitalWrite(AIN1, HIGH);  //Motor A Rotate Clockwise
    digitalWrite(AIN2, LOW);
  } else {
    digitalWrite(AIN1, LOW);  //Motor A Rotate CounterClockwise
    digitalWrite(AIN2, HIGH);
  }

  analogWrite(PWM1, motor_speed);  //Speed control of Motor A
}

void setup() {
  pinMode(LED_BUILTIN, OUTPUT);
  digitalWrite(LED_BUILTIN, HIGH);
  delay(5000);
  digitalWrite(LED_BUILTIN, LOW);
  
  attachInterrupt(digitalPinToInterrupt(3), IRS, RISING);

  Serial.begin(9600);
  pinMode(PWM1, OUTPUT);
  pinMode(AIN1, OUTPUT);
  pinMode(AIN2, OUTPUT);
  motor_speed = 255;
  motor_direction = false;
}



void loop() {

  if (flag && (digitalRead(3) == LOW)) {
    duration = millis() - high_start_time;
    flag = false;
    desired_tool = duration / 100;

  }
  //Serial.print("duration:");
  //Serial.print(duration);
  change_tool(desired_tool);
  //Serial.print(" desired_tool:");
  //Serial.println(desired_tool * 100 + 50);
  delay(1);
}
