mehmetfurkandogan/CNC-modernization/(commit log)

2023-04-20 Stepper motor driver manual is added
2023-04-26 added schematic of controller
2023-04-27 X axis stepper datasheet added.
2023-04-27 Solidworks Assembly is added
2023-05-11 Create spindle driver options.md
2023-05-11 update on spindle driver and power supply options
2023-05-17 Step Motor Driver drawings are added
    [Distance.IGS, Distance.SLDPRT, Distance.STEP, Header 200mil.IGS, Header 200mil.STEP, LED 3mm Double Stand.IGS, LED 3mm Double Stand.SLDPRT, LED 3mm Double Stand.STEP]
2023-05-18 New documents are added
    [grbl_default_settings.txt]
2023-06-16 created single pulse arduino code
2023-07-04 Create TB6600-Datasheet.pdf
    Step Motor Driver Datasheet is added.
2023-07-11 Update Speed_Reading_Code.ino
    Spindle Speed Reading Code is updated with comments and proper variable names
2023-07-11 ReadMe Updated
    Spindle part updated, electrical system and wiring parts are formed but not finished, still work to do
2023-07-17 Readme is updated
    - The powering procedure is added.
    - G-code sending, spindle speed measurement, and tool changer procedures are added.
    - Some pictures are added
    - Possible improvements of GRBL is added
    - Possible improvements of tool changer is added
2023-07-19 edited possible improvements in README file
    Added stepper motors and X axis limitation descriptions
